quangvu16/hoverboard-robot/src/robot_pose_publisher_ros2/README.md

# robot_pose_publisher_ros2

This is ros2 verison of [robot_pose_publisher](https://github.com/GT-RAIL/robot_pose_publisher)
