quangvu16/hoverboard-robot/src/robot_description/meshes/right_tire.stl

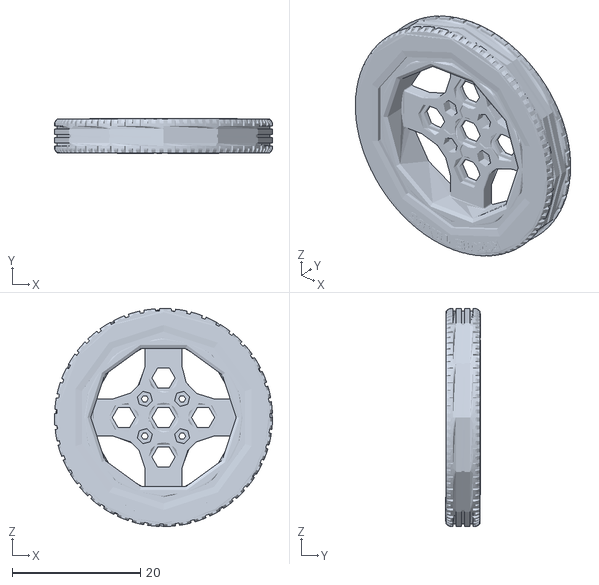
[picture p1: CAD file, 2026-10-12]
src/robot_description/meshes/right_tire.stl
34.0 x 5.46 x 34.0
