quangvu16/hoverboard-robot/src/robot_description/meshes/robot_base.stl

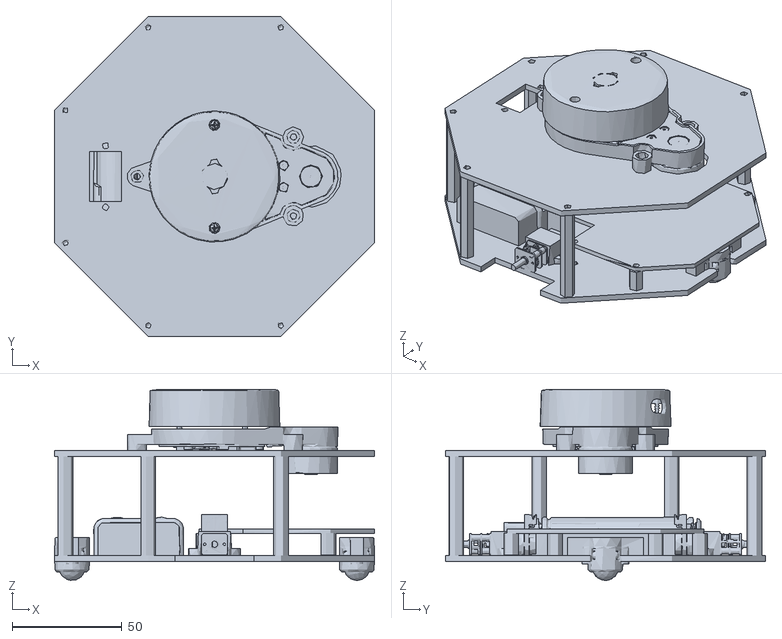
[picture p2: CAD file, 2026-10-12]
src/robot_description/meshes/robot_base.stl
146.0 x 146.0 x 87.2
