quangvu16/hoverboard-robot/(list of files, cad)

Other CAD files:
src/robot_description/meshes/left_tire.stl
