quangvu16/hoverboard-robot/website/index.fieldmanual.html

Field manual · last updated 11 Oct 2026

# A hoverboard that maps the room and drives itself there.

The motors, mainboard and battery come from a scrapped self-balancing hoverboard. An ESP32 reads the LiDAR, IMU and sonars, drives the mainboard, and sends everything over Wi-Fi to a ROS 2 Humble PC. That PC runs SLAM, Nav2 and RViz.

wheel radius 96.15 mm encoder 90 ticks/rev wheel cap 0.5 m/s LiDAR LD14P · ~6 Hz IMU MPU9250 · 50 Hz odom ~50 Hz

IDEACheap, strong baseHub motors plus an off-the-shelf FOC controller, with no motor driver to build.

INSTALLTwo firmwares, one workspaceMainboard FOC, the ESP32 sketch, and ~/robot_ws built with colcon.

DEPLOYWi-Fi, no cablesThe ESP32 streams UDP, and a systemd service starts bringup at boot.

OPERATEMap, save, navigateCartographer or slam_toolbox, then Nav2 on the saved map.

01 · Idea

## Why a hoverboard, and why split the brain in two

The robot started as a small differential-drive base built around an ESP32 that spoke JSON over TCP (esp_tcp_server_node, port 9000). That base is still supported. The project then moved to a hoverboard chassis, because the hub motors, battery and FOC mainboard come in one cheap package with plenty of torque.

The design keeps the work split cleanly. Anything that must be on time and must keep working with Wi-Fi down runs on the ESP32: wheel speed control, sonar reflexes, lights and the IMU fusion. Anything that needs real compute runs on the PC under ROS 2: maps, plans, costmaps and the EKF.

A white two-wheeled self-balancing hoverboard

The donor. A stock hoverboard like this one supplies the two hub motors, the mainboard and the 36 V battery. Photo: Soar Boards, CC BY 2.0, Wikimedia Commons (https://commons.wikimedia.org/wiki/File:Zero_G_Hands_Free_Segway_2_Wheel_Self_Balancing_Scooter_Hoverboard_(21835953610).jpg).

### On the mainboard

The motor's own FOC control loop. It zeroes its command after 0.8 s of serial silence.

### On the ESP32

A PI speed loop per wheel, the LiDAR decoder, three HC-SR04 reflexes, turn and stop lights, a buzzer and MPU9250 fusion. It knows RPM and ticks, never metres.

### On the PC

All geometry lives in metres in one YAML file. The PC also runs odometry, TF, the EKF, Cartographer or slam_toolbox, Nav2 and RViz.

02 · Hardware

## The data path, end to end

Grey wires run on the chassis. Blue datagrams travel over Wi-Fi. The bridge replies to whichever address sent the telemetry, so the PC never needs the robot's IP address.

### Components

These are stock photos of the same kind of part, not photos of this robot. They are free-licensed images from Wikimedia Commons, credited on each card. No free photo exists of the LD14P LiDAR, a hoverboard mainboard or a bare MPU9250 breakout, so those three are drawings.

ESP32 DevKit board with the WROOM-32 module

Photo: Ubahnverleih, CC0, Wikimedia Commons (https://commons.wikimedia.org/wiki/File:ESP32_Espressif_ESP-WROOM-32_Dev_Board.jpg)

### ESP32-WROOM DevKit ×1

The only processor on the robot. It decodes the LiDAR, runs the wheel speed loop, sonar reflexes and IMU fusion, and sends everything over Wi-Fi.

2 coresWi-Fi 2.4 GHzflash @ 115200

### LDROBOT LD14P LiDAR ×1

A 360° scanner that gives the robot its view of the walls. The ESP32 bins each turn into 360 ranges and sends them as LDS1 datagrams, which become /scan.

GPIO16 · UART1~6 Hzmapping range 6 m

### Hoverboard mainboard ×1

The dual BLDC motor controller from the hoverboard, running hoverboard-firmware-hack-FOC. The ESP32 talks to it through the left sensor cable (highlighted).

GPIO26/27 · UART23 wires, no VCC0.8 s timeout

Hub motor with its side panel removed, showing the stator coils and magnets

E-scooter hub motor, same design as the hoverboard's · Photo: Andrez1, CC BY-SA 4.0, Wikimedia Commons (https://commons.wikimedia.org/wiki/File:Wheel_hub_motor_of_an_electric_kick_scooter,_sidepanel_removed_(2022).jpg)

### Hub motor wheels ×2

Brushless motors built into the wheels, each with Hall sensors. Fifteen pole pairs × 6 Hall states gives 90 ticks per revolution, which the bridge turns into /odom.

r 96.15 mm90 ticks/revtrack 0.18 m (unverified)

### MPU9250 IMU ×1

A gyro and accelerometer. Its turn rate helps the EKF correct wheel slip. The compass is left off because the hub motors' magnets corrupt it.

I²C 0x68 · GPIO21/2250 Hz/imu/data

HC-SR04 ultrasonic module

Photo: Suyash Dwivedi, CC BY-SA 4.0, Wikimedia Commons (https://commons.wikimedia.org/wiki/File:HC_SR04_Ultrasonic_Module.jpg)

### HC-SR04 ultrasonic ×3

Front, left and right sensors. The ESP32 reacts to them on its own: it backs off below 350 mm at the front and turns away below 50 mm at the sides. ROS only reports the distances.

ECHO via 1k/2k divider0 = no echo/ultrasonic/*

A red 5 mm LED

5 mm LED, as used for the stop light · Photo: oomlout, CC BY-SA 2.0, Wikimedia Commons (https://commons.wikimedia.org/wiki/File:5mm_Red_LED.jpg)

### Lights & buzzer ×3 + 1

The firmware drives the turn signals and stop light from the wheel motion. The left or right light blinks while turning, and the back light stays on while stopped. ROS switches the buzzer.

LEDs GPIO14/13/5buzzer GPIO25/Buzzer

An 18650 lithium-ion cell next to an AA battery

18650 cell (right), the type hoverboard packs are built from · Photo: Lead holder, CC BY-SA 3.0, Wikimedia Commons (https://commons.wikimedia.org/wiki/File:Liion-18650-AA-battery.jpg)

### 36 V battery pack ×1

The hoverboard's original lithium pack. It powers the mainboard and motors, and the ESP32 reports its voltage (about 36.5 V when charged) in every telemetry frame.

~36.5 Vmainboard power buttondo not feed the ESP32 from VCC

### ESP32 pin map

All pins are set in config.h, the only file in the sketch you edit. Each sonar's ECHO line goes through its own 1 kΩ/2 kΩ divider, because the HC-SR04 outputs 5 V. GPIO 6–11 and 12 are refused at compile time.

GPIO | Dir | Wired to | Constant
16 | in | LiDAR TX (its RX is left unwired) | LIDAR_RX_PIN
26 / 27 | in / out | Mainboard TX / RX, left sensor cable (USART2) | HB_RX_PIN / HB_TX_PIN
21 / 22 | i/o | MPU9250 SDA / SCL | IMU_SDA_PIN / IMU_SCL_PIN
32 / 33 | out / in | Front HC-SR04 TRIG / ECHO | SONAR_TRIG_PIN / SONAR_ECHO_PIN
17 / 19 | out / in | Left HC-SR04 TRIG / ECHO | SONAR_LEFT_*
18 / 23 | out / in | Right HC-SR04 TRIG / ECHO | SONAR_RIGHT_*
14 / 13 / 5 | out | Left / right / back LEDs | LED_*_PIN
25 | out | Active buzzer | BUZZER_PIN
2, 4, 15 | — | Free (the ST7789 display was removed)

Mainboard wiring

Connect three wires only: GND, TX→GPIO26 and RX←GPIO27. Leave the mainboard's VCC pin open. It can carry 15 V and cannot power an ESP32. USART2 is 3.3 V logic and is not 5 V tolerant.

03 · Firmware

## Two firmwares and three wire formats

### Mainboard

hoverboard-firmware-hack-FOC (https://github.com/EmanuelFeru/hoverboard-firmware-hack-FOC), built with VARIANT_USART. The board here runs the stock upstream build, which sends 18-byte feedback with no wheel counters. The ESP32's own speed loop (HB_SPEED_LOOP_ON 1) holds the RPM.

### ESP32

~/Arduino/ldrobot_ld14p_esp32_mpu9250_ros uses only the ESP32 core, with no third-party libraries. The earlier BNO055 variant ldrobot_ld14p_esp32_ros is kept because its HOVERBOARD.md has the full build guide.

Datagram | Port | Direction | Contents
LDS1 | UDP 9900 | ESP32 → PC | magic, u16 count, u32 scan id, then count × u16 ranges in mm, little-endian
HBT1 | UDP 9902 | ESP32 → PC | Accumulated ticks (so a lost datagram costs nothing), RPM, battery, sonars, lights. Bytes 52–73 carry the IMU: 74 bytes in total.
HBC1 | UDP 9901 | PC → ESP32 | Wheel RPM targets; flag bit1 drives the buzzer

IMU note

The MPU9250 runs gyro and accelerometer fusion on the ESP32, with no compass, because the hub-motor magnets corrupt it. It reports in the BNO055's units, so the bridge works with either chip. The bridge holds back /imu/data until calibration reports gyro 3. Keep the robot still for about 2 s after power-on so it can learn the gyro bias.

04 · ROS 2 software

## What lives in ~/robot_ws/src

Package | Role
esp_tcp_server | The translation layer. Its three nodes are hoverboard_udp_bridge_node, udp_lidar_receiver_node and the older esp_tcp_server_node (TCP 9000, length-prefixed JSON).
hoverboard_base_node | Holds config/hoverboard_base.yaml, the only place for wheel radius, track width, ticks per revolution and speed limits.
hoverboard_description | hoverboard.urdf: a 0.33 m chassis with frames base_footprint → base_link → base_scan, imu_link, sonar_*.
robot_bringup | robot_bringup.launch.py starts the base, LiDAR, URDF and EKF. Also robot_slam.launch.py and param/ekf_hoverboard.yaml.
robot_cartographer | Cartographer, Nav2 and RViz in one launch, plus save_map, initialpose_relay and the LiDAR+IMU-only configs.
robot_navigation | param/hoverboard.yaml, the Nav2 tuning for this base, and navigation2.launch.py.
hoverboard_ctrl / _laser / _nav / _camera / _multi … | Ports of the Yahboom packages: gamepad, obstacle avoidance and tracking, calibration, patrol and multi-robot. See HOVERBOARD_PACKAGES.md.
auto_mapper, m-explore-ros2, full_coverage_path_planner | Vendored frontier explorers and a coverage planner. Each has an UPSTREAM_COMMIT file.

### Odometry and TF

- With ekf:=true (the default), the EKF owns odom → base_footprint and publishes /odom/filtered, which Nav2 and Cartographer read.
- With ekf:=false, the bridge publishes raw wheel odometry and TF.
- With wheel_odom:=false on both launches, Cartographer uses only the LiDAR and IMU and publishes /odom/cartographer.

### Second workspace

~/slam_toolbox_ws holds slam_toolbox v2.6.9, retuned for this robot: max range 6 m when mapping and 3.5 m when localizing, with a 1 s map update. These changes are uncommitted, so never reset that tree.

05 · Install

## From a blank Ubuntu 22.04 to a built workspace

### ROS 2 Humble and the stack's packages

1. Nav2, Cartographer, robot_localization, CycloneDDS and the teleop tools.
  shellCopy

sudo apt install ros-humble-desktop ros-humble-navigation2 ros-humble-nav2-bringup \
  ros-humble-cartographer-ros ros-humble-robot-localization \
  ros-humble-rmw-cyclonedds-cpp ros-humble-teleop-twist-keyboard python3-colcon-common-extensions

### Shell environment

2. Source local_setup.bash, not setup.bash. The latter replays the prefix chain recorded at build time and can pull in stale overlays.
  ~/.bashrcCopy

source /opt/ros/humble/setup.bash
source ~/slam_toolbox_ws/install/local_setup.bash
source ~/robot_ws/install/local_setup.bash
export RMW_IMPLEMENTATION=rmw_cyclonedds_cpp

### Build both overlays

3. Builds are plain colcon build, without --symlink-install. Config is read from the install space, so rebuild a package after editing its YAML.
  shellCopy

cd ~/slam_toolbox_ws && colcon build
cd ~/robot_ws && colcon build
source ~/robot_ws/install/local_setup.bash
# one package after an edit
colcon build --packages-select esp_tcp_server hoverboard_base_node

### Flash the mainboard

4. Build hoverboard-firmware-hack-FOC with VARIANT_USART. If you change its N_MOT_MAX, mixer coefficients or inverts, change the matching HB_MB_* constants in the ESP32's config.h too.

### Flash the ESP32

5. Set your Wi-Fi SSID and password in config.h. Upload at 115200 baud: faster speeds fail on this board. A flash id of ff/ffff means a wiring or hardware fault, not a software one.
  shellCopy

S=~/Arduino/ldrobot_ld14p_esp32_mpu9250_ros
arduino-cli compile --fqbn esp32:esp32:esp32 $S
arduino-cli upload  --fqbn esp32:esp32:esp32:UploadSpeed=115200 -p /dev/ttyUSB0 $S

06 · Deploy

## Bring the robot up and prove each link

### Open the network

1. The PC and ESP32 must be on the same LAN. On a VM, use a bridged adapter, not NAT.
  shellCopy

sudo ufw allow 9900/udp && sudo ufw allow 9901/udp && sudo ufw allow 9902/udp

### Power on and check the serial boot log

2. At 115200 baud you should see the Wi-Fi address, then LiDAR: sending 360-bin scans and a hoverboard: line with battery voltage. no feedback on GPIO26 means the mainboard isn't talking: TX/RX swapped, no common ground, or the power button wasn't pressed.

### Start bringup (one stack at a time)

3. Before launching, make sure no other bringup or Nav2 is running. Duplicate bridges fight over UDP 9902.
  shellCopy

ros2 launch robot_bringup robot_bringup.launch.py              # hoverboard + EKF (default)
ros2 launch robot_bringup robot_bringup.launch.py ekf:=false   # raw wheel odometry
ros2 launch robot_bringup robot_bringup.launch.py base:=esp_tcp # original small base

### Verify every link

4. shellCopy

ros2 topic echo /hoverboard/link_status   # esp:up mainboard:up …
ros2 topic hz /scan                       # ~6 Hz
ros2 topic hz /odom                       # ~50 Hz
ros2 topic echo --once /imu/calib_status  # want: gyro 3

### First drive, on blocks

5. Lift the wheels off the ground first: a hoverboard has the torque to throw the chassis. Fix wheel swaps and inverts in the ESP32's config.h, never on the ROS side.
  shellCopy

ros2 topic pub -r 10 /cmd_vel geometry_msgs/msg/Twist '{linear: {x: 0.1}}'   # both forward
ros2 topic pub -r 10 /cmd_vel geometry_msgs/msg/Twist '{angular: {z: 0.5}}'  # turn left

### Calibrate once the sensors are mounted

6. Check the scan orientation first, then the wheel track. The tools are in ~/robot_ws/tools.
  shellCopy

python3 ~/robot_ws/tools/lidar_mirror_test.py        # mirrored? rotated? turning with the robot?
python3 ~/robot_ws/tools/calib_wheel_separation.py   # odom yaw vs Cartographer yaw

### Safety layers

Where | Trigger | Action
Mainboard | 0.8 s UART silence | Zeroes its command
ESP32 | 1 s with no HBC1 | Zeroes the ROS request and keeps the mainboard armed with zeros
ESP32 sonar | front < 350 mm · side < 50 mm | Reverses, or turns away, for at most 1.5 s. Works with Wi-Fi down.
Bridge | cmd_timeout_s 0.5 s | Sends an explicit stop when /cmd_vel goes quiet

07 · Autostart

## Start the robot side at boot with systemd

A systemd service runs the same robot_bringup.launch.py as a terminal does, but it starts when the PC boots, with nobody logged in. It also restarts after a crash and writes its output to the system journal. It covers only the robot side: the bridge, LiDAR receiver, URDF and EKF. Mapping, Nav2 and RViz stay manual, because you choose a map and need a screen for them.

Proposed, not yet installed

These files aren't installed on the robot PC yet. They were checked on 11 Oct 2026: systemd-analyze verify passes. The script also started all five nodes in an isolated ROS domain and stopped them cleanly on SIGINT.

### Add the start script

1. It sets up the same environment as ~/.bashrc, which systemd doesn't read. It sources local_setup.bash, never setup.bash.
  shellCopy

cat > ~/robot_ws/tools/robot_bringup.sh <<'EOF'
#!/usr/bin/env bash
# Started by robot-bringup.service. Same environment as ~/.bashrc:
# local_setup.bash, never setup.bash.
set -e
source /opt/ros/humble/setup.bash
source "$HOME/slam_toolbox_ws/install/local_setup.bash"
source "$HOME/robot_ws/install/local_setup.bash"
export RMW_IMPLEMENTATION=rmw_cyclonedds_cpp
unset ROS_LOCALHOST_ONLY
# Extra launch arguments come from the unit's ROBOT_ARGS (e.g. "ekf:=false").
exec ros2 launch robot_bringup robot_bringup.launch.py $ROBOT_ARGS
EOF
chmod +x ~/robot_ws/tools/robot_bringup.sh

### Add the service unit

2. The unit waits for the network, because the bridge needs Wi-Fi. It runs as user vu so the workspaces in that home directory resolve. It stops with SIGINT, which shuts ros2 launch down cleanly, the same as Ctrl-C.
  shellCopy

sudo tee /etc/systemd/system/robot-bringup.service >/dev/null <<'EOF'
[Unit]
Description=Hoverboard robot bringup (bridge, LiDAR, URDF, EKF)
Wants=network-online.target
After=network-online.target

[Service]
Type=simple
User=vu
Environment=ROBOT_ARGS=
ExecStart=/home/vu/robot_ws/tools/robot_bringup.sh
# ros2 launch shuts its nodes down cleanly on SIGINT, like Ctrl-C
KillSignal=SIGINT
TimeoutStopSec=20
Restart=on-failure
RestartSec=5

[Install]
WantedBy=multi-user.target
EOF

### Enable it and start it now

3. shellCopy

sudo systemctl daemon-reload
sudo systemctl enable --now robot-bringup
systemctl status robot-bringup        # want: active (running)
ros2 topic echo /hoverboard/link_status

### Pick launch arguments (optional)

4. Set them in a drop-in file instead of editing the unit. For example, for LiDAR+IMU-only Cartographer:
  shellCopy

sudo systemctl edit robot-bringup
# in the editor, add:
[Service]
Environment=ROBOT_ARGS=wheel_odom:=false
# then
sudo systemctl restart robot-bringup

### Day-to-day commands

To | Run
Follow the logs | journalctl -u robot-bringup -f
Logs since the last boot | journalctl -u robot-bringup -b
Pick up a fresh colcon build | sudo systemctl restart robot-bringup
Run bringup by hand instead | sudo systemctl stop robot-bringup
Stop starting it at boot | sudo systemctl disable --now robot-bringup

One bringup at a time

While the service runs, don't also start robot_bringup.launch.py in a terminal. Two bridges compete for UDP 9902 and both publish /odom. Stop the service first. Start mapping and Nav2 on top of the service as usual, and keep the wheel_odom mode the same on both sides.

### What a restart covers

Restart=on-failure brings the launch back 5 s after it crashes or is killed. If one node dies, ros2 launch keeps running, so systemd doesn't restart anything. Check journalctl for process has died.

### After a rebuild

Config is read from the install space, and a running service keeps the old executables. After colcon build, restart the service so it picks up the new build.

08 · Map & navigate

## Two mapping stacks; never run both

### Cartographer (recommended)

shellCopy

# map, and navigate while mapping
ros2 launch robot_cartographer cartographer_nav.launch.py
ros2 run robot_cartographer save_map ~/m_map

# localize on the frozen map
ros2 launch robot_cartographer cartographer_nav.launch.py \
  map:=$HOME/m_map.pbstream

The 2D Pose Estimate tool in RViz works in localization mode.

### slam_toolbox + Nav2

shellCopy

# map
ros2 launch robot_bringup robot_slam.launch.py
ros2 run nav2_map_server map_saver_cli -f ~/m_map

# navigate (AMCL)
ros2 launch robot_navigation navigation2.launch.py \
  map:=$HOME/m_map.yaml

Match the modes

For LiDAR+IMU-only mapping, pass wheel_odom:=false to both bringup and cartographer_nav. If only one of them gets it, nothing publishes the odom frame and Nav2 keeps logging “Invalid frame ID "odom"”.

### Driving by hand

shellCopy

ros2 run rqt_robot_steering rqt_robot_steering        # publishes /cmd_vel_manual
ros2 run teleop_twist_keyboard teleop_twist_keyboard  # publishes /cmd_vel
ros2 launch hoverboard_ctrl joy_launch.py             # gamepad

09 · Web navigation

## Send the robot somewhere from a phone or laptop

The robot_web_nav package serves a web page from the robot PC. Any browser on the same Wi-Fi can open it, with nothing to install. The page shows the map, the robot and its planned path. Click a spot and the robot drives there through Nav2. It works with both stacks, Cartographer or Nav2 + AMCL, and you choose which one at launch.

The browser speaks plain JSON. web_nav_bridge turns Nav2's action and the TF tree into simple topics, so the page never handles either directly.

### Install rosbridge and build the package

1. shellCopy

sudo apt install ros-humble-rosbridge-suite
cd ~/robot_ws && colcon build --packages-select robot_web_nav
source install/local_setup.bash
sudo ufw allow 9090/tcp && sudo ufw allow 8000/tcp   # only if ufw is enabled

### Launch with your choice of stack

2. Bringup must already be running, either by hand or from robot-bringup.service. The launch starts rosbridge, the web server, web_nav_bridge and the chosen stack. RViz stays off, because the page replaces it.
  shellCopy

# Cartographer: localize on a saved map (no map:= = map while navigating)
ros2 launch robot_web_nav web_nav.launch.py stack:=cartographer map:=$HOME/m_map.pbstream

# Nav2 + AMCL on a .yaml map
ros2 launch robot_web_nav web_nav.launch.py stack:=amcl map:=$HOME/m_map.yaml

# nav stack already running elsewhere: web parts only
ros2 launch robot_web_nav web_nav.launch.py stack:=none

### Open the page

3. Go to http://<robot-pc-ip>:8000. The page connects to the websocket on the same host by itself. To use another address, add ?ws=ws://host:port to the page URL.

### Using the page

Control | What it does
Goal mode (G) | Click where the robot should go. Drag to set the heading it ends at. With a plain click, it faces the way it drove. A new goal replaces the active one.
Set pose mode (P) | Click where the robot really is and drag the way it faces. This publishes /initialpose, which AMCL reads directly. Cartographer reads it through initialpose_relay, only when a .pbstream map is loaded.
Pan (M), + / − / Fit / Robot | Move and zoom the map. The scroll wheel zooms around the cursor, and Robot centres the map on the robot.
Cancel goal | Stops the active goal.
Saved spots | Name the robot's current position, then tap Go to send it back there. Spots are saved in that browser only.
Status panel | Shows Driving, Arrived, Failed or Cancelled, with distance left, time left, time driving and recoveries, all from Nav2's feedback.
Header pills | Show the websocket connection, the stack in use, whether Nav2 is ready, and the map size and resolution.

### Topics for your own clients

Any client that speaks the rosbridge v2 protocol can use the same interface, for example roslibpy in Python.

Topic | Type | Direction | Notes
/web/goal | geometry_msgs/PoseStamped | to robot | frame map
/web/cancel | std_msgs/Empty | to robot | cancels the active goal
/initialpose | geometry_msgs/PoseWithCovarianceStamped | to robot | set pose
/web/robot_pose | geometry_msgs/PoseStamped | from robot | 5 Hz
/web/nav_status | std_msgs/String (JSON) | from robot | state, goal, distance_remaining, eta_s, nav_time_s, recoveries, stack, server_ready
/map, /plan | OccupancyGrid, Path | from robot | straight from the stack

### When the pills turn red

- no rosbridge / disconnected: the web launch isn't running, rosbridge isn't installed, or port 9090 is blocked. The page retries every 2 s.
- Nav2 not running: no navigate_to_pose server. Start a stack, or check its log.
- web_nav_bridge silent: the helper node has stopped. Restart the web launch.
- no map: nothing is publishing /map yet.

### Test status (11 Oct 2026)

web_nav_bridge was tested against a stand-in for Nav2: reporting Nav2 not running, the robot pose, feedback while driving, arrival, cancel, and a goal replaced mid-drive. The page loads in a browser. The map drawing and clicking to set goals still need a live check once rosbridge is installed.

10 · Android app

## Robot Nav, a native app for the same websocket

Robot Nav is a native Android app written in Kotlin. It connects straight to rosbridge and uses the same topics as the web page, so nothing changes on the robot side: start web_nav.launch.py with either stack, and the app and browser can be used side by side.

The app draws the map itself, so pinch-zoom and dragging a heading feel native. The phone remembers the robot's address and your saved spots, and keeps the screen on while you navigate.

package com.hoverboard.robotnav Android 8.0+ (API 26) APK ~1 MB one dependency OkHttp 4.12

A drawing of the screen layout, with example values (not a screenshot).

### Start the robot side

1. This is the same launch as for web navigation, and it needs ros-humble-rosbridge-suite installed.
  robot PCCopy

ros2 launch robot_web_nav web_nav.launch.py stack:=cartographer map:=$HOME/m_map.pbstream
# or: stack:=amcl map:=$HOME/m_map.yaml

### Install the APK

2. The built APK is ~/RobotNav.apk. Copy it to the phone and open it, allowing "install unknown apps". Or install it over USB with USB debugging turned on:
  robot PCCopy

~/Android/Sdk/platform-tools/adb install -r ~/RobotNav.apk

### Connect

3. Tap Robot address and enter ws://<robot-pc-ip>:9090. The default is ws://192.168.1.12:9090. The phone must be on the same Wi-Fi. If ufw is enabled, open port 9090/tcp. The app retries every 2 s whenever the connection drops.

### Touch controls

Gesture | Goal mode | Set pose mode | Pan mode
Tap | Go there, facing the way it drove | Robot is here, keeping its heading | —
Press, drag, release | Go there and end facing the drag direction | Robot is here, facing the drag direction | Move the map
Two fingers | Pinch to zoom and drag to pan, in every mode. A second finger cancels a pick in progress.
Fit / Robot | Fit the whole map, or centre on the robot

### Inside the app

- RosBridge.kt is the rosbridge v2 client over an OkHttp websocket. It re-subscribes after every reconnect and advertises a topic before its first publish.
- MapView.kt draws the occupancy grid, robot, plan and goal, and handles the touch gestures.
- MainActivity.kt handles the topics, status panel, robot address and saved spots. It decodes /map off the UI thread.

### Test status (11 Oct 2026)

The app builds cleanly, the APK is signed with the debug key, and its manifest is checked (API 26–34, internet permission, launcher entry). It hasn't run on a phone or against a live rosbridge yet.

### Rebuild on the robot PC

The toolchain is in ~/Android (JDK 17, SDK 34 and Gradle 8.7), with no Android Studio needed. On this network Java needs IPv6 preferred, because IPv4 has no route. GitHub is also unreachable, so the Gradle wrapper downloads from a mirror and checks it against the SHA-256 published by gradle.org.

robot PCCopy

cd ~/robot_ws/android_app
export JAVA_HOME=~/Android/jdk ANDROID_HOME=~/Android/Sdk \
       JAVA_TOOL_OPTIONS=-Djava.net.preferIPv6Addresses=true
./gradlew --no-daemon assembleRelease
cp app/build/outputs/apk/release/app-release.apk ~/RobotNav.apk

11 · Troubleshoot

## Symptoms seen on this robot

Symptom | Likely cause | Fix
Nav2: frame "odom" does not exist | Bringup and Cartographer were started in different wheel_odom modes | Restart both with matching arguments
Robot heads the wrong way under Nav2 | The scan isn't turning with the robot (LiDAR not fixed to the chassis), or the scan is mirrored | Run lidar_mirror_test.py with the robot on the floor
/imu/data missing; calib status shows none | The firmware can't find the chip, usually a loose I²C or VCC wire | Reseat SDA 21 / SCL 22 / 3V3 / GND and reboot
No motion from /cmd_vel | Best-effort QoS, a sonar block, or two bridges running | Check /ultrasonic/obstacle_near and run ps aux | grep ros2
Edited YAML has no effect | Config is read from the install space | Rebuild that package and re-source
Phantom obstacle at 0.23 m | The robot's own body | Costmaps and Cartographer already ignore returns under 0.30 m

12 · Status

## Where the project stands

Verified

Wheel radius 0.09615 m: odometry read 0.61 m for a real 0.60 m. The speed loop holds 30 rpm and drives 0.6 m straight at 0.2 m/s.

Working

Bridge, LiDAR at ~6 Hz, MPU9250 at 50 Hz (when its wiring holds), EKF, Cartographer and Nav2 launch files.

To do

Wheel separation (0.18 m) is still unverified. Run calib_wheel_separation.py once the LiDAR and IMU are fixed to the chassis.

To do

The IMU dropped out in the last session (calib status none), so check its wiring. Confirm the scan turns with the robot before tuning Nav2.

New

Web navigation (robot_web_nav) is built and its helper node is tested. It still needs ros-humble-rosbridge-suite installed and a live run on the robot.

New

The Robot Nav Android app (~/RobotNav.apk) is built. It still needs a run on a phone against a live rosbridge.

Reverted

A 180° front/back swap (reverse_direction) was tried and reverted on 11 Oct 2026. Re-record any map made while it was active.

### Milestones

26 Sep 2026

Yahboom stack ported to hoverboard_* packages; Nav2 tuned in hoverboard.yaml; wheel radius measured; buzzer added.

04 Oct 2026

Hoverboard base becomes the bringup default (HBT1/HBC1 over UDP 9902/9901).

07 Oct 2026

IMU support added to firmware and bridge (HBT1 grows to 74 bytes); dead ST7789 display removed.

11 Oct 2026

MPU9250 firmware in use; EKF on by default; LiDAR+IMU-only Cartographer mode; direction swap tried and reverted; systemd autostart, web navigation and the Android app added.

13 · Study

## Where to learn each piece

Official documentation and the upstream projects this robot is built on, grouped by layer.

### ROS 2 basics

- ROS 2 Humble documentation (https://docs.ros.org/en/humble/)
- ROS 2 tutorials (https://docs.ros.org/en/humble/Tutorials.html): nodes, topics, launch, colcon
- tf2 tutorials (https://docs.ros.org/en/humble/Tutorials/Intermediate/Tf2/Tf2-Main.html): frames and transforms
- URDF tutorials (https://docs.ros.org/en/humble/Tutorials/Intermediate/URDF/URDF-Main.html): describing the robot
- REP 105 (https://www.ros.org/reps/rep-0105.html): map, odom, base_link conventions
- REP 103 (https://www.ros.org/reps/rep-0103.html): units and axis directions

### Mapping & localization

- Cartographer ROS (https://google-cartographer-ros.readthedocs.io/en/latest/) and its tuning walkthrough (https://google-cartographer-ros.readthedocs.io/en/latest/algo_walkthrough.html)
- slam_toolbox (https://github.com/SteveMacenski/slam_toolbox)
- robot_localization (https://github.com/cra-ros-pkg/robot_localization): the EKF fusing odometry and IMU
- AMCL (https://docs.nav2.org/rolling/configuration_and_development/configuration_guide/others/configuring_amcl/) configuration in Nav2

### Navigation

- Nav2 documentation (https://docs.nav2.org/rolling/)
- Nav2 concepts (https://docs.nav2.org/rolling/getting_started/navigation_concepts/): behavior trees, costmaps, planners, controllers
- Nav2 tuning guide (https://docs.nav2.org/rolling/configuration_and_development/tuning_guide/)
- m-explore-ros2 (https://github.com/robo-friends/m-explore-ros2) (explore_lite) and auto_mapper (https://github.com/kaiaai/auto_mapper): frontier exploration
- full_coverage_path_planner (https://github.com/nobleo/full_coverage_path_planner): Spiral-STC coverage

### Hardware & firmware

- hoverboard-firmware-hack-FOC (https://github.com/EmanuelFeru/hoverboard-firmware-hack-FOC): mainboard firmware and wiring
- Arduino core for ESP32 (https://docs.espressif.com/projects/arduino-esp32/en/latest/)
- ldlidar_ros2 (https://github.com/ldrobotSensorTeam/ldlidar_ros2): LDROBOT LiDAR protocol and driver
- kaiaai (https://github.com/kaiaai): the ESP32 robot firmware this project started from

### Web & app control

- rosbridge_suite (https://github.com/RobotWebTools/rosbridge_suite): ROS over a websocket
- roslibjs (https://github.com/RobotWebTools/roslibjs): the JavaScript client the web page uses
- Kotlin for Android (https://developer.android.com/kotlin)

### Middleware & tools

- Eclipse Cyclone DDS (https://cyclonedds.io/docs/): the RMW used here
- colcon tutorial (https://docs.ros.org/en/humble/Tutorials/Beginner-Client-Libraries/Colcon-Tutorial.html): workspaces and overlays
- RViz guide (https://docs.ros.org/en/humble/Tutorials/Intermediate/RViz/RViz-Main.html)

Sources: ~/CLAUDE.md, robot_ws/src/HOVERBOARD_PACKAGES.md, hoverboard_base.yaml, and the firmware's config.h and HOVERBOARD.md. Wi-Fi credentials are left out of this page on purpose. Component photos come from Wikimedia Commons under the licences named on each one (CC0, CC BY 2.0, CC BY-SA 2.0/3.0/4.0). Diagrams and drawings were made for this page.
