quangvu16/hoverboard-robot/src/robot_navigation/param/hoverboard.yaml

# Nav2 parameters for the HOVERBOARD base (hoverboard mainboard + ESP32 speed
# loop, see ~/Arduino/ldrobot_ld14p_esp32_ros/HOVERBOARD.md). Derived from
# waffle.yaml (TurtleBot3 heritage), which is left unchanged. Differences:
#   * behavior_server instead of the Galactic-era recoveries_server, so the
#     spin/backup recoveries actually use these limits on Humble
#   * velocity_smoother section added (was absent -> 0.5 m/s, 2.5 rad/s,
#     2.5 m/s^2 defaults, far too violent for a hub-motor base)
#   * MPPI: 0.25 m/s, 1.0 rad/s, gentler accelerations; footprint-aware
#     collision checking (the square footprint was set but not used by MPPI)
#   * progress checker sized for a slow robot
#   * LiDAR returns closer than 0.30 m ignored: the chassis corner is 0.233 m
#     from the centre, so anything nearer is the robot itself
#   * range_layer in the local costmap: the three HC-SR04s (/range/*) for
#     what the LiDAR cannot see (glass, low objects)
#   * keepout_filter removed (no mask was ever published, only warnings)
#   * duplicate voxel_layer removed from the global costmap (2D LiDAR)
#   * odom_topic is /odom/filtered (wheel odometry + MPU9250 gyro, the
#     robot_localization EKF that robot_bringup starts with ekf:=true)
#   * planner: NavFn stated explicitly, allowed through unknown space so goals
#     at the edge of a map that is still being built are reachable
amcl:
  ros__parameters:
    use_sim_time: False
    alpha1: 0.05
    alpha2: 0.05
    alpha3: 0.05
    alpha4: 0.05
    alpha5: 0.05
    base_frame_id: "base_footprint"
    beam_skip_distance: 0.5
    beam_skip_error_threshold: 0.9
    beam_skip_threshold: 0.3
    do_beamskip: false
    global_frame_id: "map"
    lambda_short: 0.1
    laser_likelihood_max_dist: 2.0
    laser_max_range: 6.0
    laser_min_range: -1.0
    laser_model_type: "likelihood_field"
    max_beams: 360
    max_particles: 4000
    min_particles: 1000
    odom_frame_id: "odom"
    pf_err: 0.01
    pf_z: 0.99
    recovery_alpha_fast: 0.0
    recovery_alpha_slow: 0.0
    resample_interval: 1
    robot_model_type: "nav2_amcl::DifferentialMotionModel"
    save_pose_rate: 0.5
    sigma_hit: 0.1
    tf_broadcast: true
    transform_tolerance: 1.0
    update_min_a: 0.05
    update_min_d: 0.05
    z_hit: 0.8
    z_max: 0.05
    z_rand: 0.0
    z_short: 0.05
    scan_topic: scan

amcl_map_client:
  ros__parameters:
    use_sim_time: False

amcl_rclcpp_node:
  ros__parameters:
    use_sim_time: False

bt_navigator:
  ros__parameters:
    use_sim_time: False
    global_frame: map
    robot_base_frame: base_link
    odom_topic: /odom/filtered
    default_bt_xml_filename: "navigate_w_replanning_and_recovery.xml"
    bt_loop_duration: 100
    default_server_timeout: 20
    enable_groot_monitoring: True
    groot_zmq_publisher_port: 1666
    groot_zmq_server_port: 1667
    plugin_lib_names:
      - nav2_compute_path_to_pose_action_bt_node
      - nav2_compute_path_through_poses_action_bt_node
      - nav2_follow_path_action_bt_node
      - nav2_back_up_action_bt_node
      - nav2_spin_action_bt_node
      - nav2_wait_action_bt_node
      - nav2_clear_costmap_service_bt_node
      - nav2_is_stuck_condition_bt_node
      - nav2_goal_reached_condition_bt_node
      - nav2_goal_updated_condition_bt_node
      - nav2_initial_pose_received_condition_bt_node
      - nav2_reinitialize_global_localization_service_bt_node
      - nav2_rate_controller_bt_node
      - nav2_distance_controller_bt_node
      - nav2_speed_controller_bt_node
      - nav2_truncate_path_action_bt_node
      - nav2_goal_updater_node_bt_node
      - nav2_recovery_node_bt_node
      - nav2_pipeline_sequence_bt_node
      - nav2_round_robin_node_bt_node
      - nav2_transform_available_condition_bt_node
      - nav2_time_expired_condition_bt_node
      - nav2_distance_traveled_condition_bt_node
      - nav2_single_trigger_bt_node
      - nav2_is_battery_low_condition_bt_node
      - nav2_navigate_through_poses_action_bt_node
      - nav2_navigate_to_pose_action_bt_node
      - nav2_remove_passed_goals_action_bt_node
      - nav2_planner_selector_bt_node
      - nav2_controller_selector_bt_node
      - nav2_goal_checker_selector_bt_node

bt_navigator_rclcpp_node:
  ros__parameters:
    use_sim_time: False

controller_server:
  ros__parameters:
    controller_frequency: 5.0
    costmap_update_timeout: 0.30
    min_x_velocity_threshold: 0.001
    min_y_velocity_threshold: 0.001 # 0.5 for differential drive robots that have no y velocity
    min_theta_velocity_threshold: 0.001
    failure_tolerance: 0.3
    odom_topic: "odom/filtered"
    progress_checker_plugins: ["progress_checker"]
    goal_checker_plugins: ["general_goal_checker"] # "precise_goal_checker"
    controller_plugins: ["FollowPath"]
    use_realtime_priority: false

    # Progress checker parameters
    progress_checker:
      plugin: "nav2_controller::SimpleProgressChecker"
      required_movement_radius: 0.25
      movement_time_allowance: 15.0
    # Goal checker parameters
    #precise_goal_checker:
    #  plugin: "nav2_controller::SimpleGoalChecker"
    #  xy_goal_tolerance: 0.25
    #  yaw_goal_tolerance: 0.25
    #  stateful: True
    general_goal_checker:
      stateful: True
      plugin: "nav2_controller::SimpleGoalChecker"
      xy_goal_tolerance: 0.20
      yaw_goal_tolerance: 0.25
    FollowPath:
      # Model Predictive Path Integral Controller
      plugin: "nav2_mppi_controller::MPPIController"
      time_steps: 15
      model_dt: 0.2 # Set to the duration of the control frequency
      batch_size: 10000
      ax_max: 0.5
      ax_min: -0.8
      ay_max: 0.0
      az_max: 1.5
      vx_std: 0.15
      vy_std: 0.2
      wz_std: 0.3
      vx_max: 0.25   # ~25 rpm per wheel; the ESP32 speed loop was verified at 30 rpm
      vx_min: 0.0 # -0.35 is default
      vy_max: 0.0
      wz_max: 1.0
      iteration_count: 1
      prune_distance: 1.7
      transform_tolerance: 0.1
      temperature: 0.3
      gamma: 0.015
      motion_model: "DiffDrive"
      visualize: false
      regenerate_noises: false
      TrajectoryVisualizer:
        trajectory_step: 5
        time_step: 3
      critics: [
        "ConstraintCritic", "CostCritic", "GoalCritic",
        "GoalAngleCritic", "PathAlignCritic", "PathAngleCritic",
        "PathFollowCritic", "PreferForwardCritic", "TwirlingCritic"]
      ConstraintCritic:
        enabled: true
        cost_power: 1
        cost_weight: 4.0
      CostCritic:
        enabled: true
        cost_power: 1
        cost_weight: 3.81
        near_collision_cost: 253
        critical_cost: 300.0
        consider_footprint: true
        collision_cost: 1000000.0
        near_goal_distance: 1.0
        trajectory_point_step: 2
      GoalCritic:
        enabled: true
        cost_power: 1
        cost_weight: 5.0
        threshold_to_consider: 1.4
      GoalAngleCritic:
        enabled: true
        cost_power: 1
        cost_weight: 3.0
        threshold_to_consider: 0.5
      PathAlignCritic:
        enabled: true
        cost_power: 1
        cost_weight: 14.0
        max_path_occupancy_ratio: 0.05
        trajectory_point_step: 4
        threshold_to_consider: 0.5
        offset_from_furthest: 20
        use_path_orientations: false
      PathAngleCritic:
        enabled: true
        cost_power: 1
        cost_weight: 2.0
        offset_from_furthest: 4
        threshold_to_consider: 0.5
        max_angle_to_furthest: 1.0
        mode: 0
      PathFollowCritic:
        enabled: true
        cost_power: 1
        cost_weight: 5.0
        offset_from_furthest: 5
        threshold_to_consider: 1.4
      PreferForwardCritic:
        enabled: true
        cost_power: 1
        cost_weight: 5.0
        threshold_to_consider: 0.5
      TwirlingCritic:
        enabled: true
        twirling_cost_power: 1
        twirling_cost_weight: 10.0

controller_server_rclcpp_node:
  ros__parameters:
    use_sim_time: False

local_costmap:
  local_costmap:
    ros__parameters:
      update_frequency: 15.0
      publish_frequency: 5.0
      global_frame: odom
      robot_base_frame: base_link
      use_sim_time: False
      rolling_window: true
      width: 7
      height: 7
      resolution: 0.02
      # Hoverboard base: 0.33 m x 0.33 m square, drive axle assumed at the centre.
      # Inscribed radius 0.165 m, circumscribed 0.233 m.
      footprint: "[[0.165, 0.165], [0.165, -0.165], [-0.165, -0.165], [-0.165, 0.165]]"
      footprint_padding: 0.01
      plugins: ["obstacle_layer", "range_layer", "inflation_layer"]

      inflation_layer:
        plugin: "nav2_costmap_2d::InflationLayer"
        # Above the 0.233 m circumscribed radius, so a turn in place never
        # starts inside lethal cost; 3.0 lets cost fall off within that band.
        inflation_radius: 0.35
        cost_scaling_factor: 3.0
      keepout_filter:
        plugin: "nav2_costmap_2d::KeepoutFilter"
        enabled: true
        filter_info_topic: "/keepout_filter/info"

      obstacle_layer:
        plugin: "nav2_costmap_2d::ObstacleLayer"
        enabled: True
        observation_sources: scan
        scan:
          topic: /scan
          max_obstacle_height: 2.0
          clearing: True
          marking: True
          data_type: "LaserScan"
          raytrace_max_range: 3.0
          raytrace_min_range: 0.30
          obstacle_max_range: 2.5
          obstacle_min_range: 0.30

      # The three HC-SR04s (hoverboard_udp_bridge /range/*). They cover what
      # the LiDAR misses: glass, chair legs, things below the scan plane. No
      # echo is published as max_range (2 m), which clears the cone.
      #   Humble limit: this layer's occupied band is +-(resolution x range),
      #   so it marks reliably from ~0.5 m and only sometimes nearer (a near
      #   echo must land on a cell centre). Nearer than that, the collision
      #   monitor (robot_bringup) and the ESP32 reflex act on the raw ranges.
      #   Not an ObstacleLayer fed with sonar scans: see the deadlock note in
      #   hoverboard_udp_bridge.cpp.
      range_layer:
        plugin: "nav2_costmap_2d::RangeSensorLayer"
        enabled: True
        topics: ["/range/front", "/range/left", "/range/right"]
        input_sensor_type: "VARIABLE"
        clear_on_max_reading: True
        clear_threshold: 0.2
        mark_threshold: 0.8
        phi: 1.2
        inflate_cone: 1.0
        no_readings_timeout: 0.0

      static_layer:
        map_subscribe_transient_local: True

      always_send_full_costmap: True

  local_costmap_client:
    ros__parameters:
      use_sim_time: False

  local_costmap_rclcpp_node:
    ros__parameters:
      use_sim_time: False

global_costmap:
  global_costmap:
    ros__parameters:
      update_frequency: 15.0
      publish_frequency: 5.0
      global_frame: map
      robot_base_frame: base_link
      use_sim_time: False
      # Hoverboard base: 0.33 m x 0.33 m square, drive axle assumed at the centre.
      # Inscribed radius 0.165 m, circumscribed 0.233 m.
      footprint: "[[0.165, 0.165], [0.165, -0.165], [-0.165, -0.165], [-0.165, 0.165]]"
      footprint_padding: 0.01
      resolution: 0.02
      track_unknown_space: true
      plugins: ["static_layer", "obstacle_layer", "inflation_layer"]

      obstacle_layer:
        plugin: "nav2_costmap_2d::ObstacleLayer"
        enabled: True
        observation_sources: scan
        scan:
          topic: /scan
          max_obstacle_height: 2.0
          clearing: True
          marking: True
          data_type: "LaserScan"
          raytrace_max_range: 3.0
          raytrace_min_range: 0.30
          obstacle_max_range: 2.5
          obstacle_min_range: 0.30

      voxel_layer:
        plugin: "nav2_costmap_2d::VoxelLayer"
        enabled: True
        publish_voxel_map: True
        origin_z: 0.0
        z_resolution: 0.05
        z_voxels: 16
        max_obstacle_height: 2.0
        mark_threshold: 0
        observation_sources: scan
        scan:
          topic: /scan
          max_obstacle_height: 2.0
          clearing: True
          marking: True
          data_type: "LaserScan"
          raytrace_max_range: 3.0
          raytrace_min_range: 0.30
          obstacle_max_range: 2.5
          obstacle_min_range: 0.30

      static_layer:
        plugin: "nav2_costmap_2d::StaticLayer"
        map_subscribe_transient_local: True

      inflation_layer:
        plugin: "nav2_costmap_2d::InflationLayer"
        # Above the 0.233 m circumscribed radius, so a turn in place never
        # starts inside lethal cost; 3.0 lets cost fall off within that band.
        inflation_radius: 0.35
        cost_scaling_factor: 3.0

      keepout_filter:
        plugin: "nav2_costmap_2d::KeepoutFilter"
        enabled: true
        filter_info_topic: "/keepout_filter/info"

      always_send_full_costmap: True

  global_costmap_client:
    ros__parameters:
      use_sim_time: False

  global_costmap_rclcpp_node:
    ros__parameters:
      use_sim_time: False

map_server:
  ros__parameters:
    use_sim_time: False
    yaml_filename: "map.yaml"

map_saver:
  ros__parameters:
    use_sim_time: False
    save_map_timeout: 5.0
    free_thresh_default: 0.25
    occupied_thresh_default: 0.65
    map_subscribe_transient_local: True

planner_server:
  ros__parameters:
    expected_planner_frequency: 2.0
    use_sim_time: False
    planner_plugins: ["GridBased"]
    GridBased:
      plugin: "nav2_navfn_planner/NavfnPlanner"   # what actually loaded before, by default
      tolerance: 0.3
      use_astar: false
      allow_unknown: true

planner_server_rclcpp_node:
  ros__parameters:
    use_sim_time: False

behavior_server:
  ros__parameters:
    costmap_topic: local_costmap/costmap_raw
    footprint_topic: local_costmap/published_footprint
    cycle_frequency: 10.0
    behavior_plugins: ["spin", "backup", "drive_on_heading", "wait"]
    spin:
      plugin: "nav2_behaviors/Spin"
    backup:
      plugin: "nav2_behaviors/BackUp"
    drive_on_heading:
      plugin: "nav2_behaviors/DriveOnHeading"
    wait:
      plugin: "nav2_behaviors/Wait"
    global_frame: odom
    robot_base_frame: base_link
    transform_tolerance: 0.1
    use_sim_time: False
    simulate_ahead_time: 2.0
    max_rotational_vel: 0.8
    min_rotational_vel: 0.3
    rotational_acc_lim: 1.5

velocity_smoother:
  ros__parameters:
    use_sim_time: False
    smoothing_frequency: 20.0
    scale_velocities: False
    feedback: "OPEN_LOOP"
    max_velocity: [0.25, 0.0, 1.0]
    min_velocity: [-0.15, 0.0, -1.0]
    max_accel: [0.5, 0.0, 1.5]
    max_decel: [-0.8, 0.0, -2.0]
    odom_topic: "odom/filtered"
    odom_duration: 0.1
    deadband_velocity: [0.0, 0.0, 0.0]
    velocity_timeout: 1.0

robot_state_publisher:
  ros__parameters:
    use_sim_time: False

waypoint_follower:
  ros__parameters:
    loop_rate: 200
    stop_on_failure: false
    waypoint_task_executor_plugin: "wait_at_waypoint"
    wait_at_waypoint:
      plugin: "nav2_waypoint_follower::WaitAtWaypoint"
      enabled: True
      waypoint_pause_duration: 200
