quangvu16/hoverboard-robot/src/hoverboard_ai_car/hoverboard_ai_car/FingerCtrl.py

#!/usr/bin/env python3
# encoding: utf-8
import threading
import cv2 as cv
import numpy as np
from hoverboard_ai_car.media_library import *
import time
import rclpy
from rclpy.node import Node
from std_msgs.msg import Int32, Bool,UInt16
from cv_bridge import CvBridge
from sensor_msgs.msg import Image, CompressedImage

from rclpy.time import Time
import datetime

class PoseCtrlArm(Node):
    def __init__(self,name):
        super().__init__(name)
        self.pub_Servo1 = self.create_publisher(Int32,"servo_s1" , 10)
        self.pub_Servo2 = self.create_publisher(Int32,"servo_s2" , 10)

        self.PWMServo_X = 0
        self.PWMServo_Y = 50
        self.s1_init_angle = Int32()
        self.s1_init_angle.data = self.PWMServo_X
        self.s2_init_angle = Int32()
        self.s2_init_angle.data = self.PWMServo_Y

        #确保角度正常处于中间
        for i in range(10):
            self.pub_Servo1.publish(self.s1_init_angle)
            self.pub_Servo2.publish(self.s2_init_angle)
            time.sleep(0.1)


        self.media_ros = Media_ROS()
        self.hand_detector = HandDetector()
        self.arm_status = True
        self.locking = True
        self.init = True
        self.pTime = 0
        self.add_lock = self.remove_lock = 0
        self.event = threading.Event()
        self.event.set()

        
        

    def process(self, frame):
        #frame = cv.flip(frame, 1)
        frame, lmList, bbox = self.hand_detector.findHands(frame)
        if len(lmList) != 0:
            threading.Thread(target=self.car_ctrl_threading, args=(lmList,bbox)).start()
        self.media_ros.pub_imgMsg(frame)
        return frame

    def go_quadrilateral(self):
        self.media_ros.pub_vel(0.3, 0.0,0.0)
        time.sleep(3)
        self.media_ros.pub_vel(0.0, 0.0,0.0)
        time.sleep(1)
        self.media_ros.pub_vel(0.0, 0.0,1.0)
        time.sleep(2.2)
        self.media_ros.pub_vel(0.0, 0.0,0.0)
        time.sleep(1)


        self.media_ros.pub_vel(0.3, 0.0,0.0)
        time.sleep(3)
        self.media_ros.pub_vel(0.0, 0.0,0.0)
        time.sleep(1)
        self.media_ros.pub_vel(0.0, 0.0,1.0)
        time.sleep(2.2)
        self.media_ros.pub_vel(0.0, 0.0,0.0)
        time.sleep(1)

        self.media_ros.pub_vel(0.3, 0.0,0.0)
        time.sleep(3)
        self.media_ros.pub_vel(0.0, 0.0,0.0)
        time.sleep(1)
        self.media_ros.pub_vel(0.0, 0.0,1.0)
        time.sleep(2.2)
        self.media_ros.pub_vel(0.0, 0.0,0.0)
        time.sleep(1)


        self.media_ros.pub_vel(0.3, 0.0,0.0)
        time.sleep(3)
        self.media_ros.pub_vel(0.0, 0.0,0.0)
        time.sleep(1)
        self.media_ros.pub_vel(0.0, 0.0,1.0)
        time.sleep(2.2)
        self.media_ros.pub_vel(0.0, 0.0,0.0)
        time.sleep(1)

    def go_s(self):
        self.media_ros.pub_vel(0.3, 0.0,-0.5)
        time.sleep(3)
        self.media_ros.pub_vel(0.0, 0.0,0.0)
        time.sleep(1)
        self.media_ros.pub_vel(0.3, 0.0,0.5)
        time.sleep(3)
        self.media_ros.pub_vel(0.0, 0.0,0.0)
        time.sleep(1)

    def Go_circle(self,flag):
        if (flag == 1):
            self.media_ros.pub_vel(0.3, 0.0,0.5)
            time.sleep(13)
            self.media_ros.pub_vel(0.0, 0.0,0.0)
        if (flag != 1):
            self.media_ros.pub_vel(0.3, 0.0,-0.5)
            time.sleep(13)
            self.media_ros.pub_vel(0.0, 0.0,0.0)


    def car_ctrl_threading(self, lmList,bbox):
        if self.event.is_set():
            self.event.clear()
            fingers = self.hand_detector.fingersUp(lmList)
            gesture = self.hand_detector.get_gesture(lmList)
            if gesture == "Yes":	
                self.go_quadrilateral()
                time.sleep(0.5)

            elif gesture == "OK":
                self.Go_circle(1)
                time.sleep(1.0)

            elif gesture == "Thumb_down":
                self.media_ros.pub_vel(0.3, 0.0,0.0)
                time.sleep(2)
                self.media_ros.pub_vel(-0.3, 0.0,0.0)
                time.sleep(2)
                self.media_ros.pub_vel(0.0, 0.0,0.0)
                time.sleep(1)

            elif fingers[1] == fingers[4] == 1 and sum(fingers) == 2:
                self.go_s()
                time.sleep(0.5)

            elif sum(fingers) == 5: 
                self.media_ros.pub_vel(0.0, 0.0,0.0)
                time.sleep(1)

            self.event.set()


class MY_Picture(Node):
    def __init__(self, name):
        super().__init__(name)
        self.bridge = CvBridge()
        self.sub_img = self.create_subscription(
            CompressedImage, '/camera/image_raw/compressed', self.handleTopic, 1) #获取esp32传来的图像
        
        self.pose_ctrl = PoseCtrlArm('posectrlarm')
        self.last_stamp = None
        self.new_seconds = 0
        self.fps_seconds = 1

    def handleTopic(self, msg):
        self.last_stamp = msg.header.stamp  
        if self.last_stamp:
            total_secs = Time(nanoseconds=self.last_stamp.nanosec, seconds=self.last_stamp.sec).nanoseconds
            delta = datetime.timedelta(seconds=total_secs * 1e-9)
            seconds = delta.total_seconds()*100

            if self.new_seconds != 0:
                self.fps_seconds = seconds - self.new_seconds

            self.new_seconds = seconds#保留这次的值

        start = time.time()
        frame = self.bridge.compressed_imgmsg_to_cv2(msg)
        frame = cv.resize(frame, (640, 480))
        cv.waitKey(1)

        frame = self.pose_ctrl.process(frame)
        
        end = time.time()
        fps = 1 / ((end - start)+self.fps_seconds)
        
        text = "FPS : " + str(int(fps))
        cv.putText(frame, text, (10,20), cv.FONT_HERSHEY_SIMPLEX, 0.8, (0,255,255), 2)
        cv.imshow('frame', frame)



def main():
    rclpy.init() 
    esp_img = MY_Picture("My_Picture")
    print("start it")
    try:
        rclpy.spin(esp_img)
    except KeyboardInterrupt:
        pass
    finally:
        esp_img.destroy_node()
        rclpy.try_shutdown()
