quangvu16/hoverboard-robot/(commit log)

2026-10-12 Add the ESP32 firmware (MPU9250 and BNO055 sketches); Wi-Fi credentials moved to an ignored secrets.h
2026-10-12 Website: add the YouTube video section and a Watch the video button
2026-10-18 Firmware: add an ESP32-S3-DevKitC-1 v1.1 build of the MPU9250 sketch
    Pin map moved off GPIOs the S3 lacks (22-25) or reserves (26-37 flash and
    octal PSRAM, 19/20 USB, 38 RGB LED, strapping 0/3/45/46), with compile-time
    checks. README documents the new wiring and flash commands.
2026-10-18 Firmware: add an ESP32 vs ESP32-S3 pinout sheet
2026-10-18 Firmware: document the ESP32-S3-N16R8 (45 GPIOs, 24 safe to wire)
2026-10-18 robot_web_nav: drive the robot by hand from the web page
    Joystick + WASD/arrow keys publish /cmd_vel_manual over rosbridge at 10 Hz
    while held, then a few zeros. Speed/turn sliders, Stop, sonar indicator;
    grabbing the stick cancels an active Nav2 goal, losing focus stops.
2026-10-18 Android app: drive stick on /cmd_vel_manual
    JoystickView + Drive: 10 Hz Twist while held, zero burst on release, speed and
    turn caps (remembered), Stop button, sonar pill; starting to drive cancels
    an active Nav2 goal, leaving the app stops.
2026-10-18 Website: live drive stick in the web navigation chapter
    Connects straight to rosbridge (plain WebSocket, no library), publishes
    /cmd_vel_manual at 10 Hz while held with the same stop/cancel rules as the
    robot_web_nav page and the app. Keys only while the panel has focus.
2026-10-18 Firmware: drive page + WebSocket served by the ESP32 (no PC needed)
    web_drive.h: minimal HTTP + WebSocket server on port 80 (ESP32 core only:
    WiFi, ESPmDNS, mbedtls), page in web_page.h. 'D <rpm_l> <rpm_r>' / 'S' from
    the page go through a mailbox to hoverboardTask, so the sonar reflex and the
    mainboard timeout still apply; the stick overrides HBC1 while held and hands
    back after WEB_DRIVE_TIMEOUT_MS. Both MPU9250 sketches (WROOM and S3).
2026-10-19 Low-battery protection on the ESP32
    battery.h: filtered mainboard voltage -> ok / low (wheel targets x0.5, chirp)
    / critical (wheels held at zero, double chirp), 10 s confirm, latched until
    37.0 V. Thresholds above the mainboard's BAT_DEAD (3.37 V/cell). Applied after
    the sonar gate, so it covers ROS, the web stick and the reflex alike.
    HBT1 grows to 78 bytes (state, cells, filtered volts); the bridge publishes
    /hoverboard/battery_state (latched), logs changes, and still accepts 74-byte
    firmware. Drive page shows the state. Both MPU9250 sketches.
2026-10-19 Firmware updates over Wi-Fi (OTA)
    ota.h: ArduinoOTA (ESP32 core) with a required password from secrets.h;
    answers only while the robot stands still, holds the wheels at zero from the
    first byte to the reboot. mDNS moved to the WiFi code so the drive page and
    OTA share hoverboard.local (ROBOT_HOSTNAME).
    tools/ota_upload.sh: build + espota upload, password from the sketch's
    secrets.h (so the new image keeps OTA on), fixed PC port 38232 for firewalls.
    Tested against a fake ArduinoOTA device. Both MPU9250 sketches.
2026-10-19 Sonars into Nav2, collision monitor and twist_mux command priorities
    - hoverboard_udp_bridge: HC-SR04s as sensor_msgs/Range on /range/{front,left,
    right} (10 Hz, stamped 50 ms back so the costmap never waits on TF; no echo =
    range_max); subscribe_cmd_vel_manual param for the mux.
    - robot_bringup: velocity chain Nav2 /cmd_vel -> collision_monitor (LiDAR +
    sonars, front slow/stop zones) -> /cmd_vel_safe -> twist_mux (manual over
    Nav2, /cmd_vel_lock) -> /cmd_vel_mux -> bridge. cmd_mux:=auto falls back
    without ros-humble-twist-mux; collision_monitor:=false.
    - hoverboard.yaml: RangeSensorLayer in the local costmap. Not an ObstacleLayer
    fed with sonar LaserScans: tf2_ros 0.25.23/.24 Me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
2026-10-19 Website: firmware features (phone drive, low battery, OTA, ESP32-S3) and the Nav2 safety chain
    Firmware chapter: drive page served by the ESP32, low-battery states, Wi-Fi
    updates, ESP32-S3 pin changes; HBT1 now 78 bytes. Map & navigate: velocity
    chain diagram, sonars in Nav2, collision monitor, twist_mux + lock, tf2
    deadlock warning. New troubleshoot rows, status rows and milestones.
2026-10-19 Android app: battery, sonar distances and the twist_mux lock
    - battery pill from /hoverboard/battery_{state,volts} (low / critical)
    - front/left/right distances from /range/* under the stick
    - Hold still / Release buttons for /cmd_vel_lock (re-sent every 2 s while
    holding; label shows the topic's last value; stick greyed while held)
    - bridge: /range/* published reliable, so rosbridge also receives them when
    the app connected before bringup (Nav2 / collision monitor still match)
2026-10-19 robot_web_nav page: battery, sonar distances and the twist_mux lock
    Battery pill from /hoverboard/battery_{state,volts}, front/left/right
    distances from /range/*, Hold still / Release for /cmd_vel_lock (re-sent
    every 2 s while holding; stick and keys disabled while the lock is on).
    Same features as the Android app. Tested with a mock rosbridge.
2026-10-19 Website: battery, sonar distances and the twist_mux lock in the live drive panel
    Same features as the robot_web_nav page and the Android app, over the
    panel's raw rosbridge WebSocket; chapter 09/10 text and a status row.
    Tested with a mock WebSocket.
2026-10-19 README: new features in the overview, layout, web/app section and status
    Diagram shows /range/*, battery and the /cmd_vel_mux input; repository
    layout mentions the safety chain, sonar range layer, ESP32-S3, PINOUT.md
    and ota_upload.sh; the web page / app / project page features in one table;
    status lists what is tested without the robot and what is left to do.
2026-10-19 Website: data path, safety layers, packages and web-page tables catch up
    Data-path drawing shows /range/*, battery state, /cmd_vel_mux and the ESP32
    battery stop; safety layers add ESP32 battery, drive page, twist_mux lock and
    collision monitor; package table mentions the safety chain and sonar range
    layer; chapter 09 controls and topics tables list drive stick, Hold still,
    battery and sonar.
2026-10-19 BatteryState and auto-docking
    - hoverboard_udp_bridge: sensor_msgs/BatteryState on /battery_state (1 Hz):
    ESP32-filtered voltage, rough per-cell Li-ion percentage, health from the
    ESP32 state; current/charging unknown (motor-side current only).
    - robot_docking (new): dock_manager saves the dock (robot pose when docked,
    ~/.ros/robot_dock.json), docks by Nav2 to a staging pose 0.7 m out and then
    reversing in on TF (stops 1 cm short), undocks 0.7 m forwards, and docks by
    itself when the ESP32 reports battery low. /dock/command, /dock/status.
    Nav2's opennav_docking 0.0.2 was tried first and dropped: its backwards
    docking turned the robot round / undocked into the wall in simulation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
2026-10-19 Docking in the Android app and on the website
    App: Dock section (Set dock here with confirmation, Dock, Undock, Cancel,
    auto-dock checkbox) on /dock/command and /dock/status, the dock drawn on the
    map, battery % from /battery_state.
    Website: docking section in chapter 08 (how it docks, set/dock/auto, limits,
    why not Nav2's docking server, shell commands); chapter 09/10 tables and
    text, troubleshoot rows, status and timeline; the live drive panel gets
    Dock / Undock (Cancel while busy) and battery %. Panel tested with a mock
    WebSocket.
2026-10-19 Explore and patrol buttons on the web page
    - explore_lite (vendored): start_paused parameter; pausing cancels only its
    own goal (cancel_all also killed the page's and the dock's goals); resume
    re-sends it; fixed an uninitialised last_progress_ (clock-type crash) and
    UnknownGoalHandleError when cancelling a finished goal.
    - web_nav.launch.py: explore_lite (paused) in mapping mode, explore:=auto.
    - web_nav_bridge: /web/explore start/stop -> /explore/resume, explore state
    in /web/nav_status; /web/patrol runs saved spots robot-side (loops, wait,
    one retry, skip), patrol progress in the status; page goal / cancel /
    patrol / docking pause exploring, goal / cancel / docking end a patrol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
2026-10-19 web_nav_bridge /web/lidar summary; LiDAR points and status on the web page
    /web/lidar (2 Hz JSON): scan rate, valid/total points, nearest return outside
    the robot body (range, bearing), age, and up to 180 points in base_footprint
    via TF. The robot_web_nav page draws the points around the robot and shows a
    LiDAR line in the Robot section. Bridge output checked against a fake /scan;
    the page change is not yet browser-tested.
2026-10-19 RUNNING.md: step-by-step guide to run every feature
    Setup (packages incl. rosbridge, twist_mux, tf2 upgrade; firewall; secrets),
    flashing (USB, OTA), bringup and its arguments, link checks, driving (PC,
    web page, app, project panel, ESP32 phone page), mapping (by hand, Explore,
    slam_toolbox, LiDAR+IMU), navigation, patrol, docking, safety features,
    autostart, calibration and troubleshooting; what is tested where.
    Linked from the README.
